HydrogreenPollub/hydrogen-cylinder-pcb/README.md

## Hydrogen cylinder unit PCB

CADLAB preview: [link](https://cadlab.io/project/27808)
