HydrogreenPollub/hydrogen-cylinder-pcb/DRV8801PWP.stp

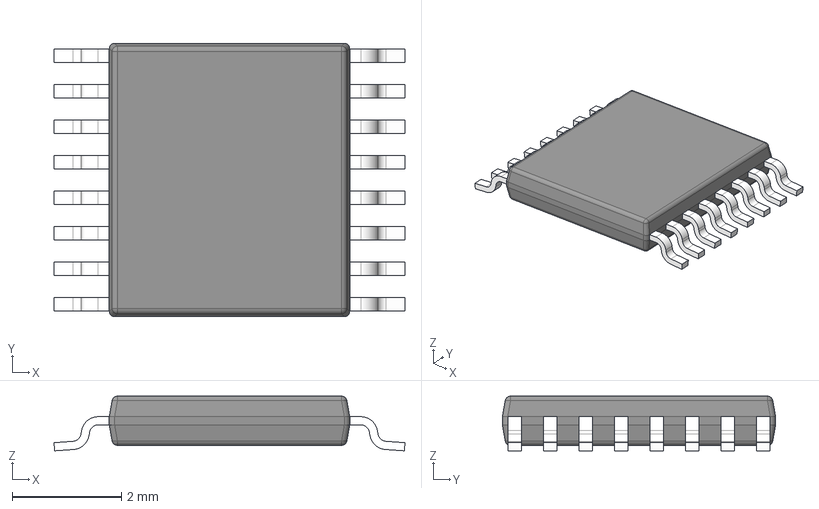
[picture p1: CAD file, 2024-03-17]
DRV8801PWP.stp
6.42 x 5.00 x 1.00 mm
BODY-SO
LEAD-SO x 16
THERMALPAD-SO
PIN1-ID
