HydrogreenPollub/hydrogen-cylinder-pcb/1N5817.stp

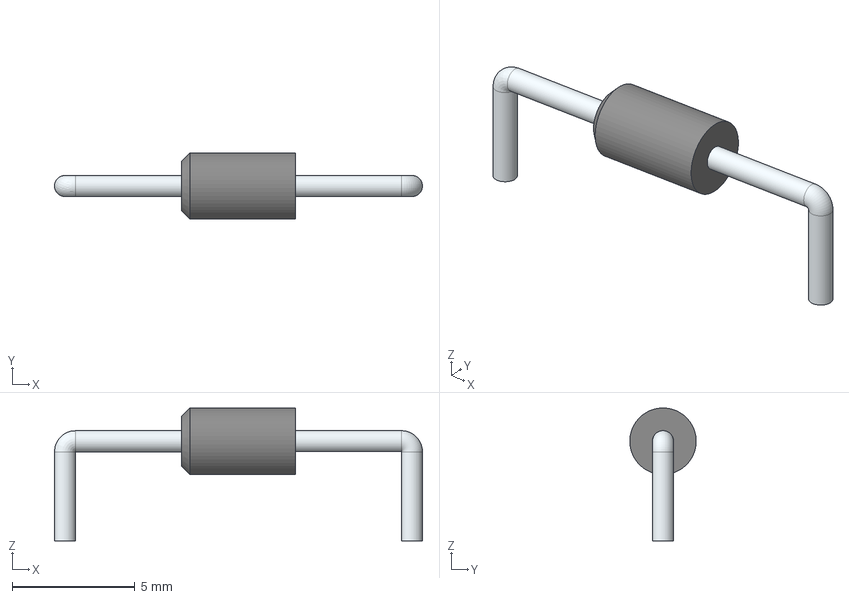
[picture p2: CAD file, 2024-02-23]
1N5817.stp
15.0 x 2.71 x 5.42 mm
