HydrogreenPollub/hydrogen-cylinder-pcb/PMPB15XPAX.stp

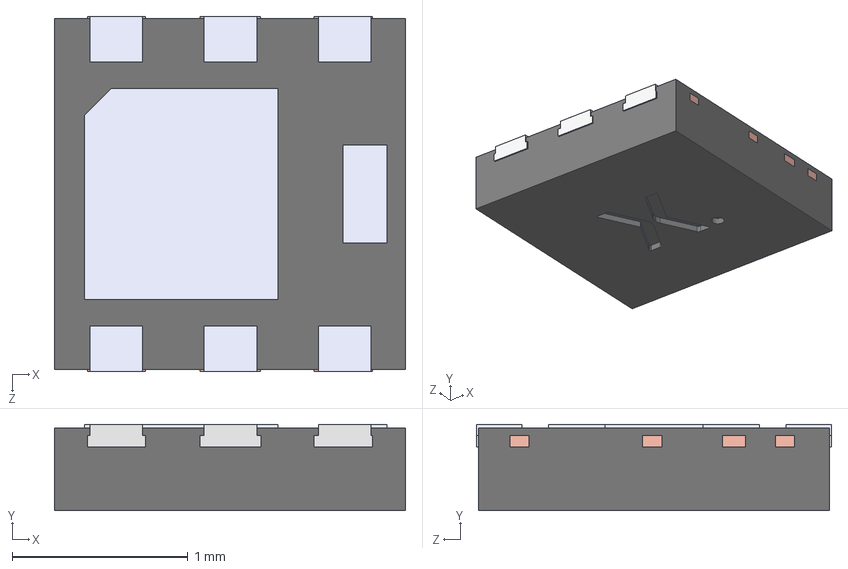
[picture p3: CAD file, 2024-02-23]
PMPB15XPAX.stp
2.00 x 0.49 x 2.02 mm
SOT1220 Body
SOT1220 Lead
