HydrogreenPollub/hydrogen-cylinder-pcb/TSR_1-2450.stp

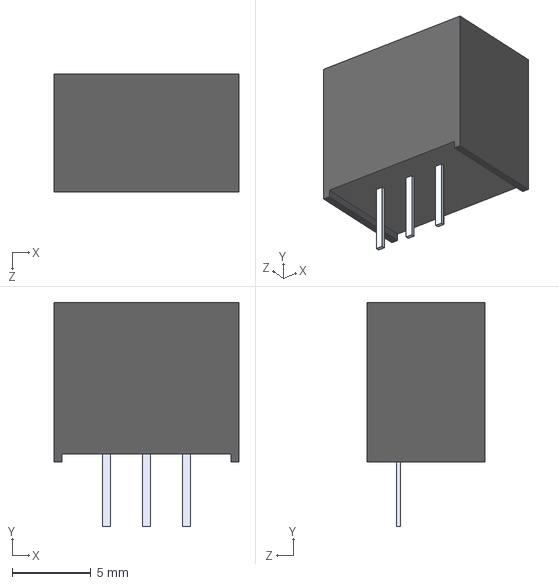
[picture p4: CAD file, 2024-02-10]
TSR_1-2450.stp
11.7 x 14.2 x 7.50 mm
