HydrogreenPollub/hydrogen-cylinder-pcb/schematic-main.kicad_pcb

## KiCad design schematic-main.kicad_pcb (2024-03-28)

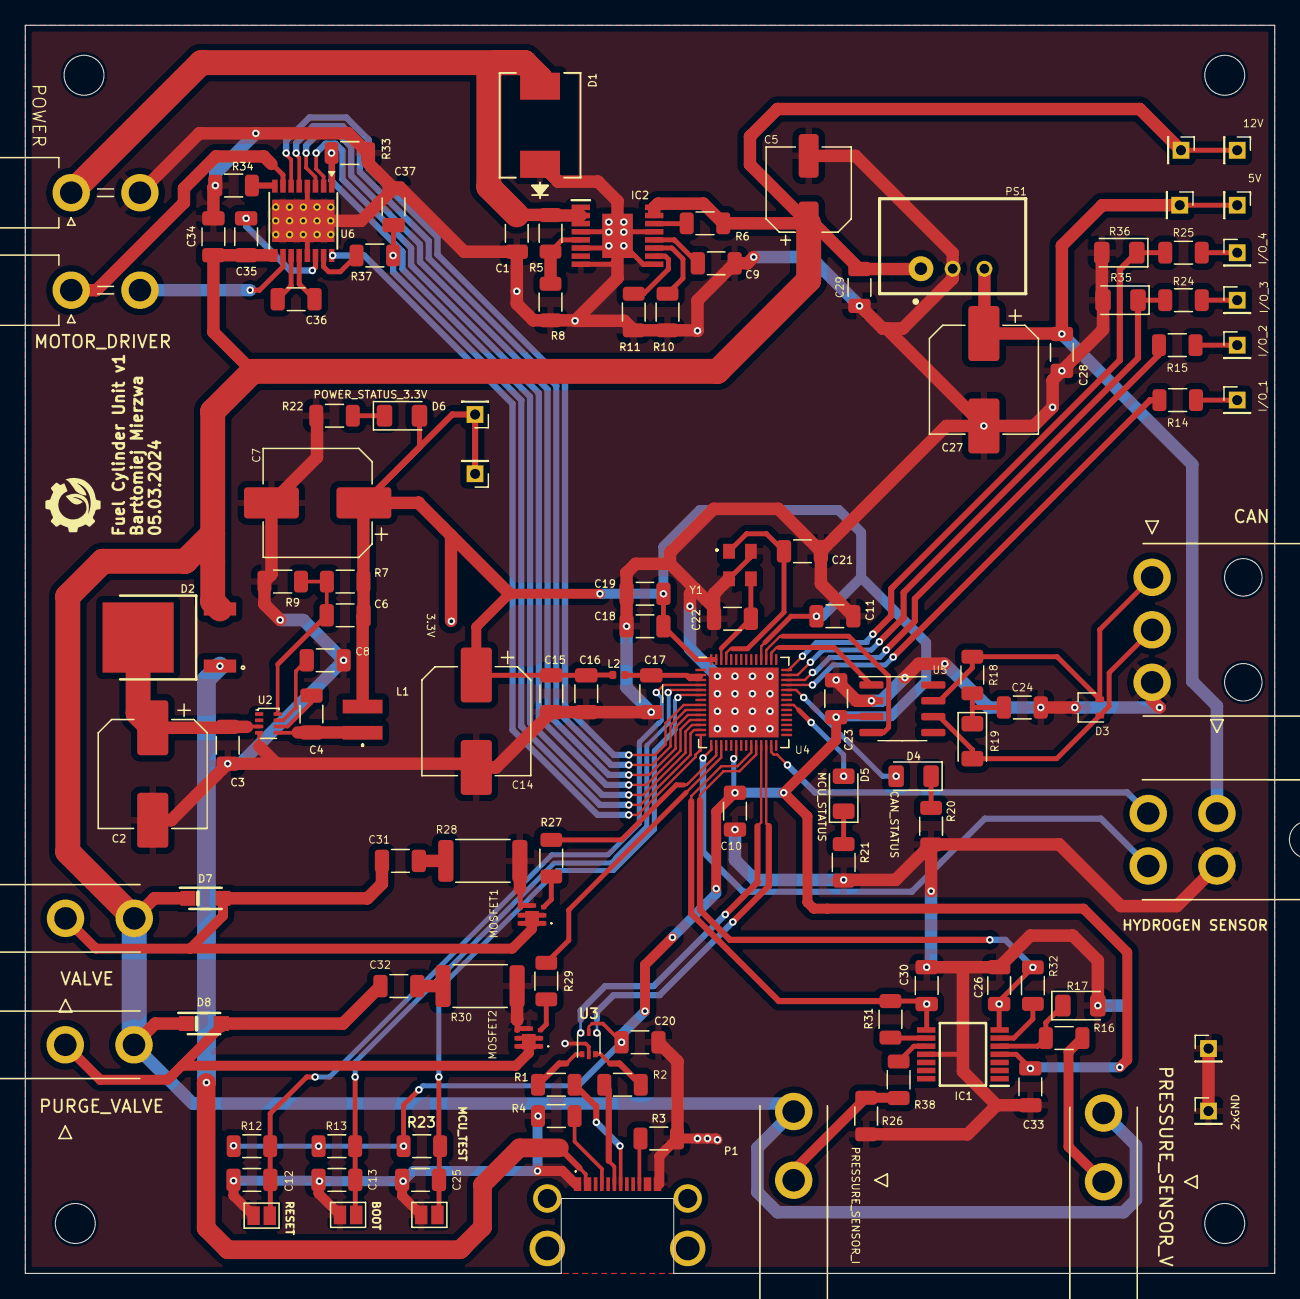
[picture p5: board schematic-main.kicad_pcb from above]

Board: 2 copper layers, 100.0 x 99.9 mm, 124 parts (0 on the bottom side), 78 nets.

Parts:
C1, C12, C13, C15, C18, C25: 1u; C_1206_3216Metric
C2, C14, C27: 10u; CP_Elec_8x10.5
C3, C4, C10, C11, C16, C17, C20, C23, C28, C29, C33, C34, C35, C36: 100n; C_1206_3216Metric
C5: 47u; CP_Elec_6.3x7.7
C6: 47p; C_1206_3216Metric
C7: 100u; CP_Elec_8x10.5
C8: 33n; C_1206_3216Metric
C9: 2n7; C_1206_3216Metric
C19: 10n; C_1206_3216Metric
C21, C22: 12p; C_1206_3216Metric
C24, C26, C30: 4n7; C_1206_3216Metric
C31, C32: 20n; C_1206_3216Metric
C37: 1n; C_1206_3216Metric
D1: TPSMC30CA; TPSMCSeries_LTF
D2: MBRD20100CT-13; TO252_(DPAK)_1
D3: SP0502BAJT; SOT-323_SC-70
D4, D5, D6: LED; D_1206_3216Metric
D7, D8: PMEG10020; PMEG10020ELR
H1, H2, H3, H4: MountingHole; MountingHole_3.2mm_M3_DIN965
IC1: AD8544ARUZ-REEL; SOP65P640X120-14N
IC2: LM76202QPWPRQ1; SOP65P640X120-17N
J1: Battery; Molex_Mini-Fit_Jr_5569-02A2_2x01_P4.20mm_Horizontal
J2: CAN; 39303035
J3: V_P; 39-30-102Y
J4: Conn_01x04; 39-30-104Y
J7: C_P; 39-30-102Y
J8: VALVE; 39-30-102Y
J9: PURGE_VALVE; 39-30-102Y
J10: Motor; Molex_Mini-Fit_Jr_5569-02A2_2x01_P4.20mm_Horizontal
JP1, JP2, JP3: SolderJumper_2_Open; SolderJumper-2_P1.3mm_Open_Pad1.0x1.5mm
L1: 4u7; SRN3015TA4R7M
L2: 2n; L_0402_1005Metric
MOSFET1, MOSFET2: PMPB15XP_115; PMPB15XPAX
P1: USB_C_Plug_USB2.0; 2169900002
PS1: TSR_1-2450; TSR-1-24120
R1, R2, R38: 0; R_1206_3216Metric
R3, R4: 5k1; R_1206_3216Metric
R5: 180k; R_1206_3216Metric
R6, R11, R37: 100k; R_1206_3216Metric
R7: 32k; R_1206_3216Metric
R8: 12k; R_1206_3216Metric
R9, R12, R13, R23, R33: 10k; R_1206_3216Metric
R10: 56k; R_1206_3216Metric
R14, R15, R20, R21, R22, R31, R32: 1k; R_1206_3216Metric
R16: 5k; R_1206_3216Metric
R17, R35, R36: 10k; LED_1206_3216Metric
R18: 60; R_1206_3216Metric
R19: 60; LED_1206_3216Metric
R24, R25: 100R; R_1206_3216Metric
R26: 150R; R_1206_3216Metric
R27, R29: 180R; R_1206_3216Metric
R28, R30: 100R 0,5W; R_2512_6332Metric
R34: 0.2; R_1206_3216Metric
TP1, TP2: GND; PinHeader_1x01_P2.00mm_Vertical
TP3, TP4: +12V; PinHeader_1x01_P2.00mm_Vertical
TP5, TP6: +5V; PinHeader_1x01_P2.00mm_Vertical
TP7, TP8: +3.3V; PinHeader_1x01_P2.00mm_Vertical
TP9: I/O 1; PinHeader_1x01_P2.00mm_Vertical
TP10: I/O 2; PinHeader_1x01_P2.00mm_Vertical
TP11: I/O 3; PinHeader_1x01_P2.00mm_Vertical
TP12: I/O 4; PinHeader_1x01_P2.00mm_Vertical
U2: TPS62933; SOT-583-8
U3: USBLC6-2P6; SOT-666
U4: ESP32-S3FN8; QFN-56-1EP_7x7mm_P0.4mm_EP5.6x5.6mm
U5: SN65HVD232; SOIC-8_3.9x4.9mm_P1.27mm
U6: DRV8801PWP; HTSSOP-16-1EP_4.4x5mm_P0.65mm_EP3.4x5mm_Mask3x3mm_ThermalVi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
Y1: Crystal_GND24; KC3225K400000C1GE00

Connections:
+3.3V: C6.1, C7.1, C10.1, C11.1, C14.1, C15.1, C16.1, C18.1, C19.1, C20.1, C23.1, C33.1, D6.2 (A), IC1.4 (V+), L1.2, L2.1, R7.1, R12.2, R13.2, R23.2, TP7.1, TP8.1, U3.5 (VBUS), U4.20 (VDD3P3_RTC), U4.46 (VDD3P3_CPU), U4.55 (VDDA), U4.56 (VDDA), U5.3 (VCC)
+5V: C27.1, C28.1, J4.1, PS1.3 (VOUT+), TP5.1, TP6.1
+12V: C5.1, C29.1, C34.1, C35.1, D2.2, D7.1 (K), D8.1 (K), IC2.15 (OUT_1), IC2.16 (OUT_2), J3.2, J7.2, J8.2, J9.2, PS1.1 (VIN+), R6.1, TP3.1, TP4.1, U6.9 (VBB)
/ADC_MOTOR: C37.1, R37.2, U4.13 (GPIO8/ADC1_CH7)
/DECAY_MODE_MOTOR: U4.11 (GPIO6/ADC1_CH5), U6.2 (MODE1)
/DIRECTION_MOTOR: U4.10 (GPIO5/ADC1_CH4), U6.3 (PHASE)
/DRIVER_SIDE: U4.14 (GPIO9/ADC1_CH8), U6.16 (MODE2)
/ENABLE_MOTOR: U4.8 (GPIO3/ADC1_CH2), U6.6 (ENABLE)
/FAULT_MOTOR: R33.1, U4.12 (GPIO7/ADC1_CH6), U6.1 (~FAULT)
/HYDROGEN_SENSOR_: J4.3, U4.27 (GPIO21)
/HYDROGEN_SENSOR_ADC: J4.4, U4.15 (GPIO10/ADC1_CH9)
/IO/CANH: D3.2 (K), J2.1, R18.2, U5.7 (CANH)
/IO/CANL: D3.1 (K), J2.2, R19.2, U5.6 (CANL)
/IO/CAN_RX: U4.44 (MTCK/JTAG/GPIO39), U5.1 (D)
/IO/CAN_TX: U4.45 (MTDO/JTAG/GPIO40), U5.4 (R)
/IO/LED_CAN_STATUS: D4.2 (A), U4.38 (GPIO33)
/IO/LED_MCU_STATUS: D5.2 (A), U4.35 (SPID/GPIO32)
/IO/PRESSURE_SENSOR_I: J7.1, R26.2, R38.1
/IO/PRESSURE_SENSOR_V: J3.1, R16.1
/IO/PURGE_VALVE: C32.1, D8.2 (A), J9.1, MOSFET2.1, MOSFET2.2, MOSFET2.5, MOSFET2.6, MOSFET2.7
/IO/VALVE: C31.1, D7.2 (A), J8.1, MOSFET1.1, MOSFET1.2, MOSFET1.5, MOSFET1.6, MOSFET1.7
/IO_2/+MOTOR: J10.1, U6.7 (OUT+)
/IO_2/-MOTOR: J10.2, U6.10 (OUT-)
/I/O_1_MCU: R14.2, U4.39 (GPIO34)
/I/O_2_MCU: R15.2, U4.40 (GPIO35)
/I/O_3_MCU: R24.2, R35.1, U4.41 (GPIO36)
/I/O_4_MCU: R25.2, R36.1, U4.42 (GPIO37)
/MCU/BOOT: C13.1, JP2.1 (A), R13.1, U4.5 (GPIO0/BOOT)
/MCU/MCU_TEST: C25.1, JP3.1 (A), R23.1, U4.6 (GPIO1/ADC1_CH0)
/MCU/RESET: C12.1, JP1.1 (A), R12.1, U4.4 (CHIP_PU/RESET)
/MCU/USB_D+: R2.2, U3.3 (I/O2), U3.4 (I/O2), U4.26 (GPIO20/USB_D+/ADC2_CH9)
/MCU/USB_D-: R1.2, U3.1 (I/O1), U3.6 (I/O1), U4.25 (GPIO19/USB_D-/ADC2_CH8)
/MCU/XTAL_N: C21.1, U4.53 (XTAL_N), Y1.1
/MCU/XTAL_P: C22.1, U4.54 (XTAL_P), Y1.3
/PRESSURE_SENSOR_I_MCU: C30.1, IC1.8 (OUT_C), R31.1, U4.23 (GPIO17/ADC2_CH6)
/PRESSURE_SENSOR_V_MCU: C26.1, IC1.7 (OUT_B), R32.2, U4.24 (GPIO18/ADC2_CH7)
/PURGE_VALVE_MCU: R29.2, U4.17 (GPIO12/ADC2_CH1)
/Power /Vin: C1.1, D1.2 (A), IC2.1 (IN_1), IC2.2 (IN_2), IC2.3 (UVLO), J1.1, R5.1
/SLEEP_MOTOR: U4.9 (GPIO4/ADC1_CH3), U6.5 (~SLEEP)
/VALVE_MCU: R27.2, U4.16 (GPIO11/ADC2_CH0)
/VBUS: D2.1, P1.A4 (VBUS), P1.A9 (VBUS), P1.B4 (VBUS), P1.B9 (VBUS)
GND: C1.2, C2.2, C3.2, C5.2, C7.2, C8.2, C9.2, C10.2, C11.2, C12.2, C13.2, C14.2, C15.2, C16.2, C17.2, C18.2, C19.2, C20.2, C21.2, C22.2, C23.2, C24.2, C25.2, C26.2, C27.2, C28.2, C29.2, C30.2, C33.2, C34.2, C37.2, D1.1 (K), D3.3 (A), IC1.11 (GND), IC2.4 (NC_1), IC2.6 (MODE), IC2.8 (RTN), IC2.9 (GND), IC2.13 (NC_2), IC2.17 (EP), J1.2, J2.3, J4.2, JP1.2 (B), JP2.2 (B), JP3.2 (B), MOSFET1.4, MOSFET1.8, MOSFET2.4, MOSFET2.8, P1.A1 (GND), P1.A12 (GND), P1.B1 (GND), P1.B12 (GND), PS1.2 (GND), R3.2, R4.2, R8.2, R9.2, R10.2, R11.2, R17.2, R20.2, R21.2, R22.2, R26.1, R28.2, R30.2, R33.2, R34.2, R35.2, R36.2, TP1.1, TP2.1, U2.4 (GND), U3.2 (GND), U4.57 (GND), U5.2 (GND), U6.4 (GND), U6.13 (GND), U6.17 (GND(PPAD)), Y1.2, Y1.4
unnamed: C24.1, R18.1, R19.1
unnamed: C31.2, R28.1
unnamed: C32.2, R30.1
unnamed: D4.1 (K), R20.1
unnamed: D5.1 (K), R21.1
unnamed: D6.1 (K), R22.1
unnamed: IC1.5 (+IN_B), R16.2, R17.1
unnamed: IC1.10 (+IN_C), R38.2
unnamed: IC1.6 (-IN_B), R32.1
unnamed: IC1.9 (-IN_C), R31.2
unnamed: C9.1, IC2.12 (DVDT)
unnamed: IC2.11 (ILIM), R10.1
unnamed: IC2.10 (IMON), R11.1
unnamed: IC2.5 (OVP), R5.2, R8.1
unnamed: IC2.14 (~FLT), R6.2
unnamed: MOSFET1.3, R27.1
unnamed: MOSFET2.3, R29.1
unnamed: P1.A5 (CC), R4.1
unnamed: P1.A6 (D+), R2.1
unnamed: P1.A7 (D-), R1.1
unnamed: P1.B5 (VCONN), R3.1
unnamed: R14.1, TP9.1
unnamed: R15.1, TP10.1
unnamed: R24.1, TP11.1
unnamed: R25.1, TP12.1
unnamed: C4.1, U2.6 (BST)
unnamed: C6.2, R7.2, R9.1, U2.8 (FB)
unnamed: C8.1, U2.7 (SS)
unnamed: C4.2, L1.1, U2.5 (SW)
unnamed: C2.1, C3.1, D2.3, U2.3 (VIN)
unnamed: C36.1, U6.11 (CP1)
unnamed: C36.2, U6.12 (CP2)
unnamed: R34.1, U6.8 (SENSE)
unnamed: C35.2, U6.14 (VCP)
unnamed: R37.1, U6.15 (VPROPI)
VDD3P3: C17.1, L2.2, U4.2 (VDD3P3), U4.3 (VDD3P3)
