HydrogreenPollub/hydrogen-cylinder-pcb/(commit log)

2023-10-17 Send initial files
    [pcb.kicad_pcb, schematc-io.kicad_sch, schematic-main.kicad_sch, schematic-power.kicad_sch]
2024-02-10 Repair & add IO schema
    [schematc-io.kicad_sch, schematic-main.kicad_sch, schematic-mcu.kicad_sch, schematic-power.kicad_sch, wzor.kicad_pcb]
2024-02-23 Add footprints
    [1N5817.stp, PMPB15XPAX.stp, TSR_1-2450.stp, schematc-io.kicad_sch, schematic-main.kicad_pcb, schematic-main.kicad_sch, schematic-mcu.kicad_sch, schematic-power.kicad_sch]
2024-02-23 Add footprints, Placing MCU
    [1N5817.stp, PMPB15XPAX.stp, TSR_1-2450.stp, schematc-io.kicad_sch, schematic-main.kicad_pcb, schematic-main.kicad_sch, schematic-mcu.kicad_sch, schematic-power.kicad_sch]
2024-03-05 Drawing PCB
    [schematc-io.kicad_sch, schematic-main.kicad_pcb, schematic-main.kicad_sch, schematic-mcu.kicad_sch]
2024-03-05 Makin GND sphere
    [schematic-main.kicad_pcb, schematic-main.kicad_sch]
2024-03-07 Changing resistance of Voltage divider
    [schematc-io.kicad_sch]
2024-03-12 Adding connector for Hydrogen Sensor
    [schematc-io.kicad_sch, schematic-main.kicad_pcb, schematic-main.kicad_sch, schematic-mcu.kicad_sch, schematic-power.kicad_sch]
2024-03-17 Adding motor driver unit
    [DRV8801PWP.stp, schematc-io.kicad_sch, schematic-main.kicad_pcb, schematic-main.kicad_sch, schematic-mcu.kicad_sch, untitled.kicad_sch]
2024-03-19 Change of dimensions
    [schematc-io.kicad_sch, schematic-main.kicad_pcb, schematic-main.kicad_sch, schematic-mcu.kicad_sch]
2024-03-22 Change of PRESSURE_SENSOR_I circuit
    [schematc-io.kicad_sch, schematic-main.kicad_pcb]
2024-03-22 Change of signatures
    [schematic-main.kicad_pcb]
2024-03-26 Change of socket for Hudrogen sensor
    [schematc-io.kicad_sch, schematic-main.kicad_pcb]
2024-03-27 Changing width of mounting holes
    [schematic-main.kicad_pcb]
2024-03-28 Change presure sensor socket
    [schematic-main.kicad_pcb, schematic-main.kicad_sch]
2024-03-28 Adding descriptions
    [schematic-main.kicad_pcb]
2024-03-28 Adding descriptions V2
    [schematic-main.kicad_pcb]
2024-03-30 DRC test copmlate
    [pcb.kicad_pcb, schematic-main_HCU.kicad_pcb, wzor.kicad_pcb]
2024-03-30 PCB complate
    [schematic-main_HCU-B_Cu.gbr, schematic-main_HCU-B_Mask.gbr, schematic-main_HCU-B_Paste.gbr, schematic-main_HCU-B_Silkscreen.gbr, schematic-main_HCU-Edge_Cuts.gbr, schematic-main_HCU-F_Cu.gbr, schematic-main_HCU-F_Mask.gbr, schematic-main_HCU-F_Paste.gbr]
2024-04-05 Rename and send to production
    [pcb_schematic_main_HCU.kicad_pcb]
